piersonjones704/Scissor-Lift-Project/README.md

# Scissor Lift Project 
## Preventing scissor lift collisions on construction sites

### Overview  
This project, developed in collaboration with **Skanska**, aims to reduce jobsite accidents by integrating a **low-cost collision detection and avoidance system** into industrial scissor lifts.  

---

### Team  
- **Team Members:** Pierson Jones, Parker Jones, Jack Oakman, Aaryan Nanekar 
- **Project Lead:** Pierson Jones
- **Mechatronics Team Lead:** Parker Jones 
- **Client Partner:** Skanska USA

---

### License  
This project is currently **private and under client collaboration**. Portions may be shared publicly for academic or demonstration purposes only.

---

### Acknowledgements  
Special thanks to **Skanska, Duke University’s EGR101 & EGR102 Course, Dr. Glass, and Shane Trent** for mentorship, technical guidance, and access to testing and prototyping facilities.
