piersonjones704/Scissor-Lift-Project/Generation1/docs/images/morphChart.jpg

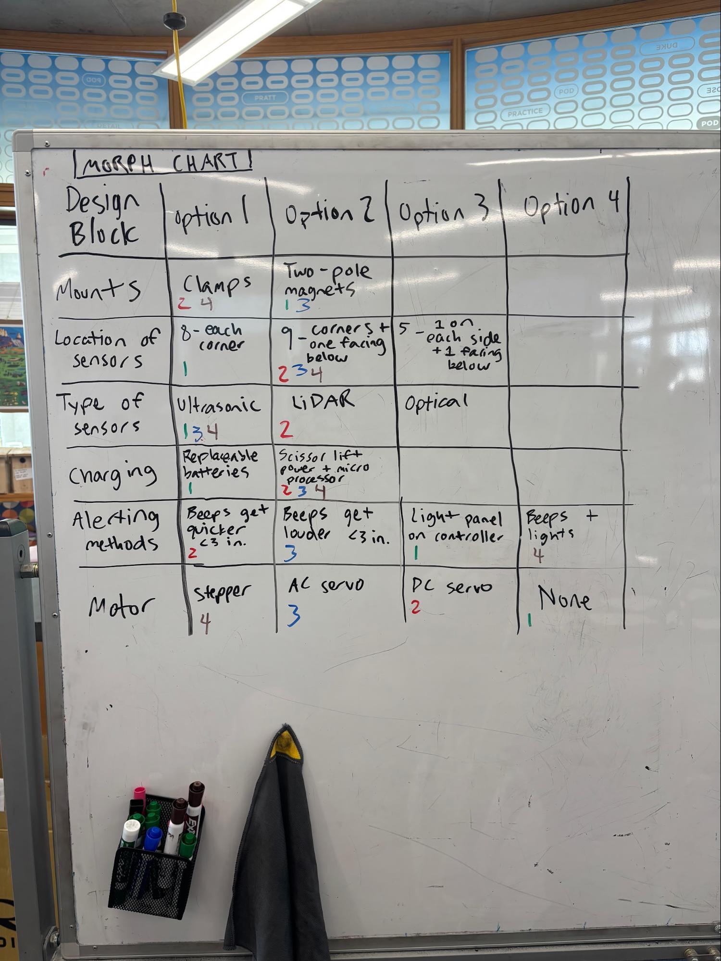
Generation1/docs/images/morphChart.jpg
