piersonjones704/Scissor-Lift-Project/Generation1/Planning Docs/IMG_5374.jpg

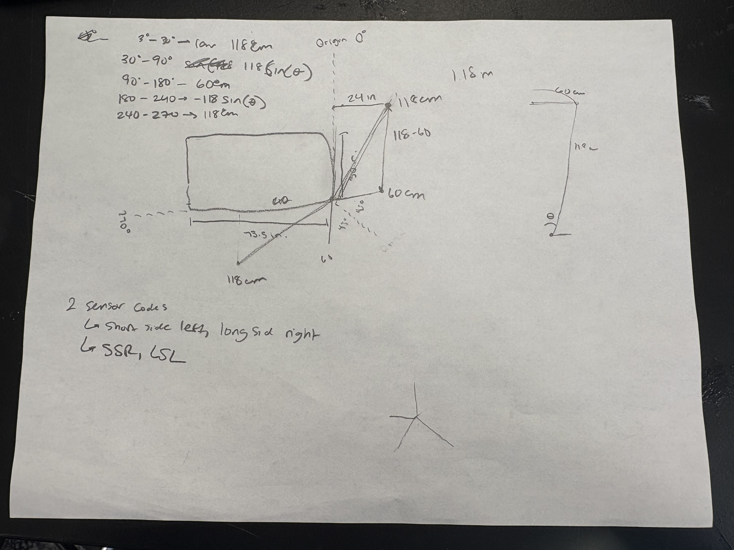
Generation1/Planning Docs/IMG_5374.jpg
