piersonjones704/Scissor-Lift-Project/Generation1/Planning Docs/Trig_SL_Sensing.jpg

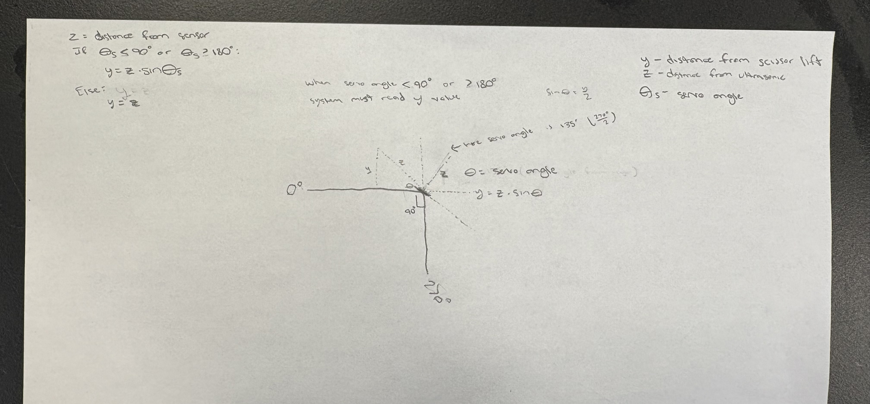
Generation1/Planning Docs/Trig_SL_Sensing.jpg
