piersonjones704/Scissor-Lift-Project/Generation2/InitialTofPrototyping/VL53L7CX Prototyping/VL53L7CX_System_Architecture.png

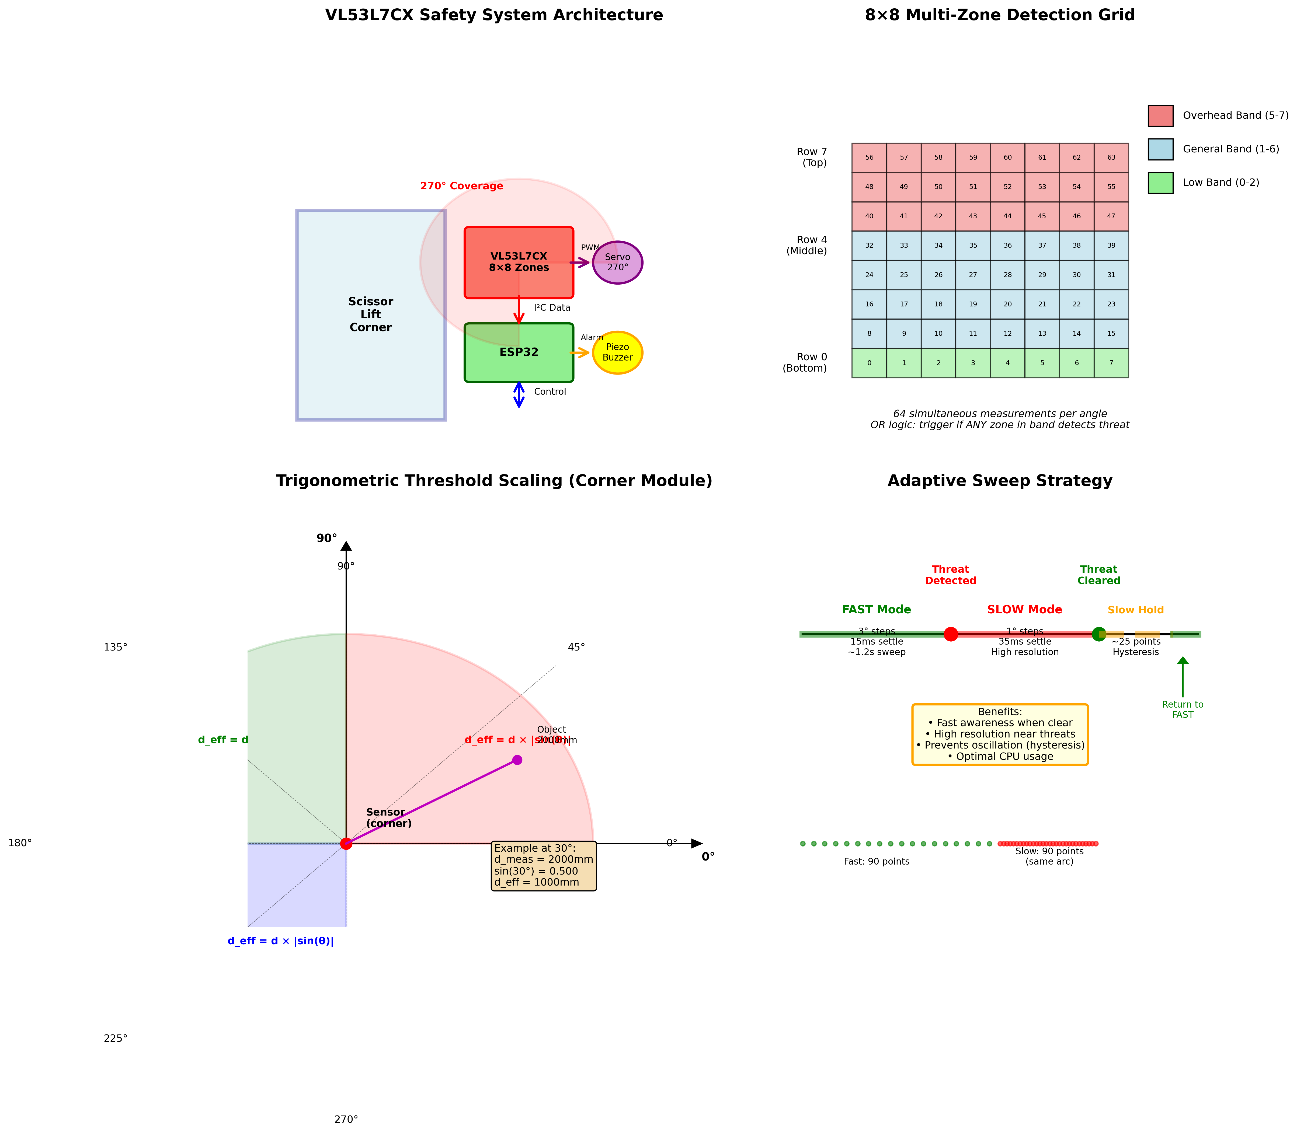
Generation2/InitialTofPrototyping/VL53L7CX Prototyping/VL53L7CX_System_Architecture.png
