piersonjones704/Scissor-Lift-Project/Generation2/TofBreakoutBoardDesign/DuPontVersion/Images/3DModelBottomView.png

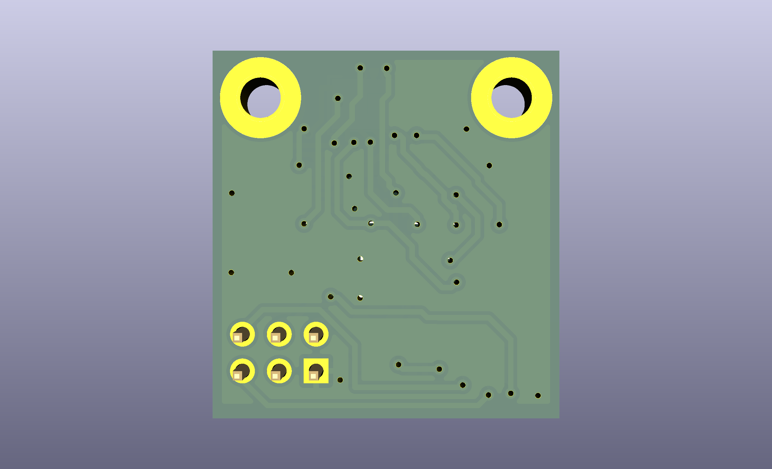
Generation2/TofBreakoutBoardDesign/DuPontVersion/Images/3DModelBottomView.png
