piersonjones704/Scissor-Lift-Project/Generation2/TofBreakoutBoardDesign/DuPontVersion/Images/3DModelFrontAngledView.png

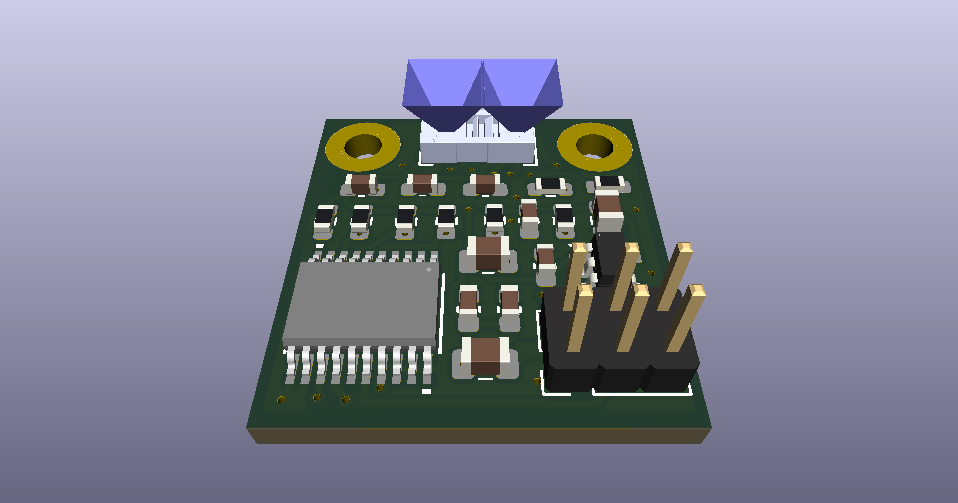
Generation2/TofBreakoutBoardDesign/DuPontVersion/Images/3DModelFrontAngledView.png
