piersonjones704/Scissor-Lift-Project/Generation2/TofBreakoutBoardDesign/DuPontVersion/Images/3DModelTopView.png

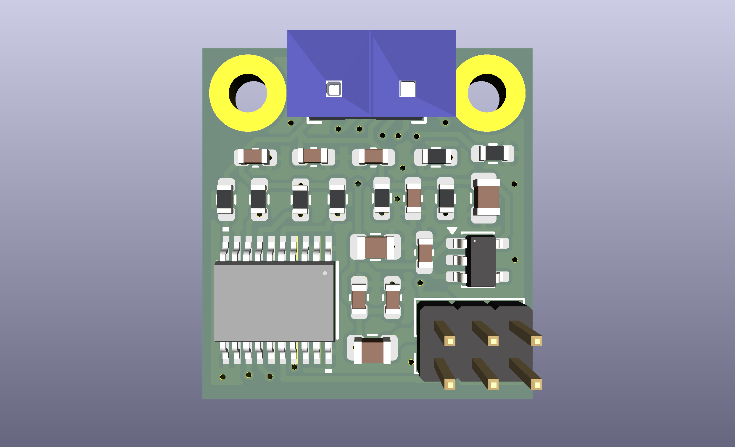
Generation2/TofBreakoutBoardDesign/DuPontVersion/Images/3DModelTopView.png
