piersonjones704/Scissor-Lift-Project/Generation2/TofBreakoutBoardDesign/DuPontVersion/Images/FrontAngledView.png

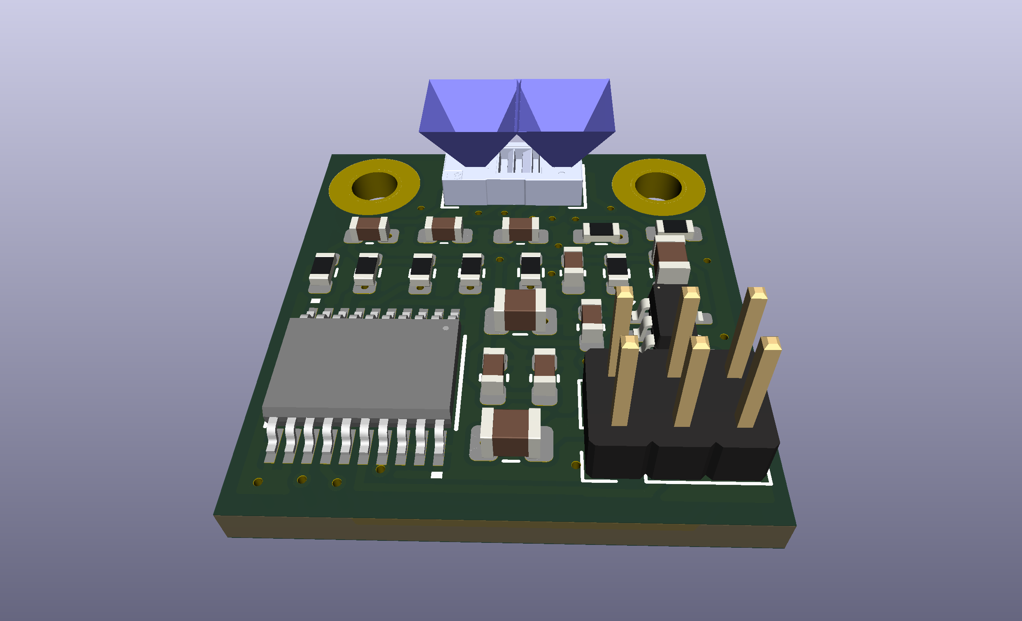
Generation2/TofBreakoutBoardDesign/DuPontVersion/Images/FrontAngledView.png
