piersonjones704/Scissor-Lift-Project/Generation2/TofBreakoutBoardDesign/DuPontVersion/Images/PCB_BackTracings.png

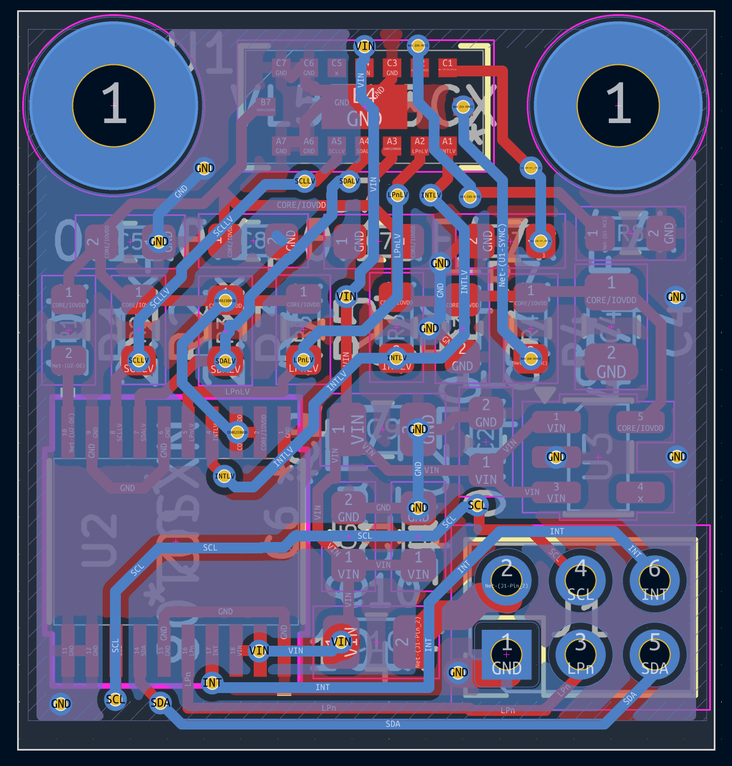
Generation2/TofBreakoutBoardDesign/DuPontVersion/Images/PCB_BackTracings.png
