piersonjones704/Scissor-Lift-Project/Generation2/TofBreakoutBoardDesign/DuPontVersion/Images/PCB_Front.png

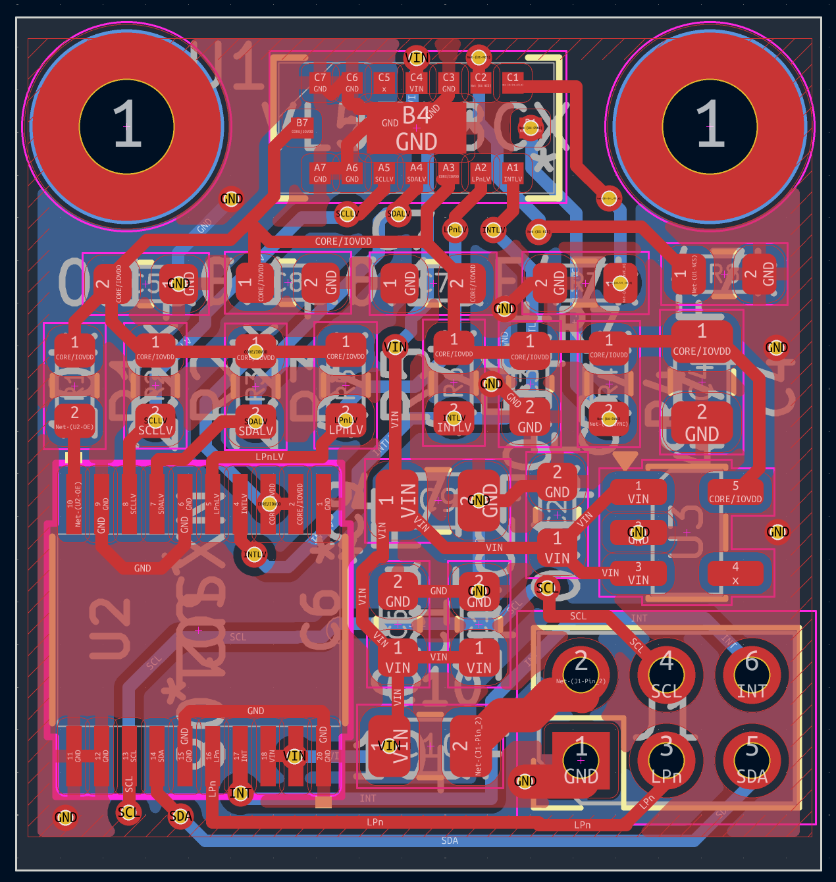
Generation2/TofBreakoutBoardDesign/DuPontVersion/Images/PCB_Front.png
