piersonjones704/Scissor-Lift-Project/Generation2/TofBreakoutBoardDesign/JST1x6RightAngleMountVersion/Images/3DModelBottomView.png

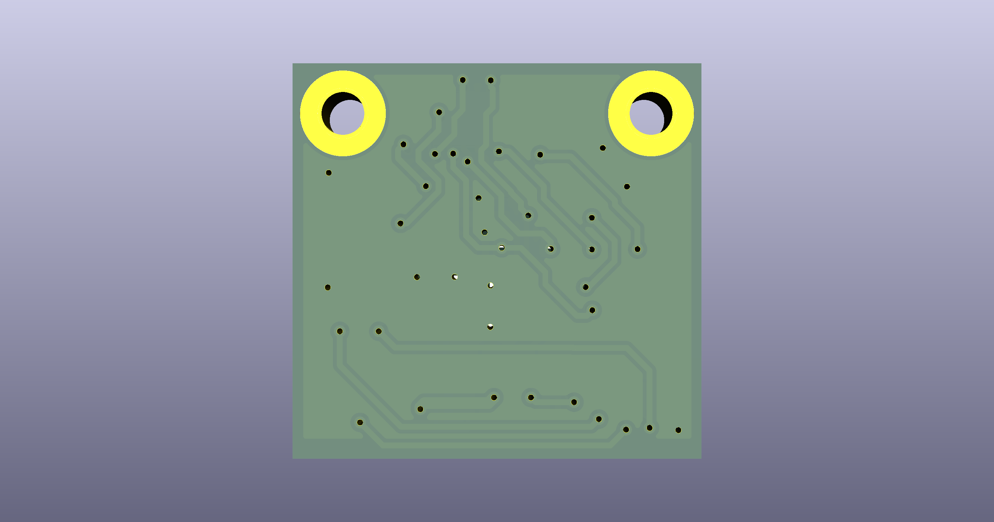
Generation2/TofBreakoutBoardDesign/JST1x6RightAngleMountVersion/Images/3DModelBottomView.png
