piersonjones704/Scissor-Lift-Project/Generation2/TofBreakoutBoardDesign/JST1x6RightAngleMountVersion/Images/3DModelTopView.png

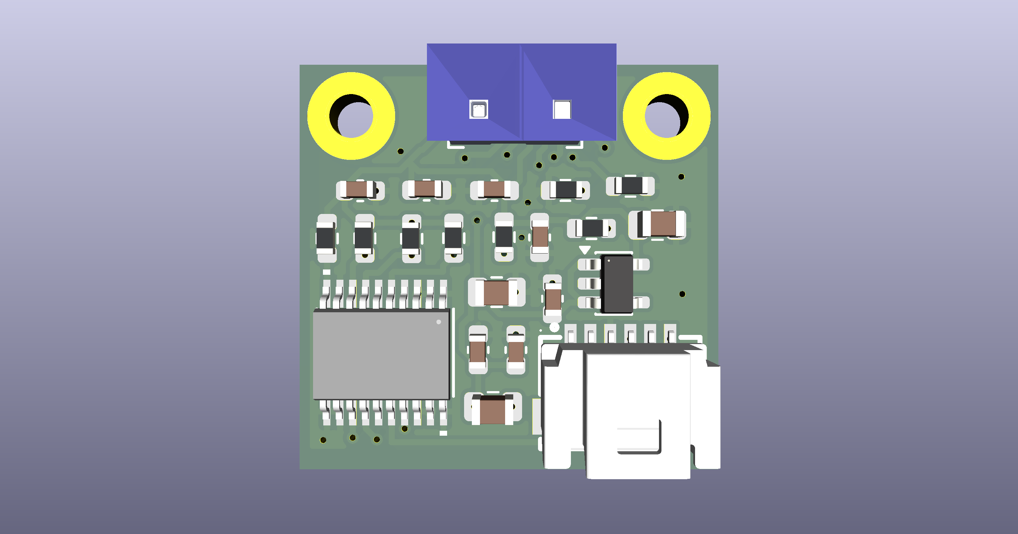
Generation2/TofBreakoutBoardDesign/JST1x6RightAngleMountVersion/Images/3DModelTopView.png
