piersonjones704/Scissor-Lift-Project/Generation2/TofBreakoutBoardDesign/JST1x6RightAngleMountVersion/Images/PCB_FrontTracings.png

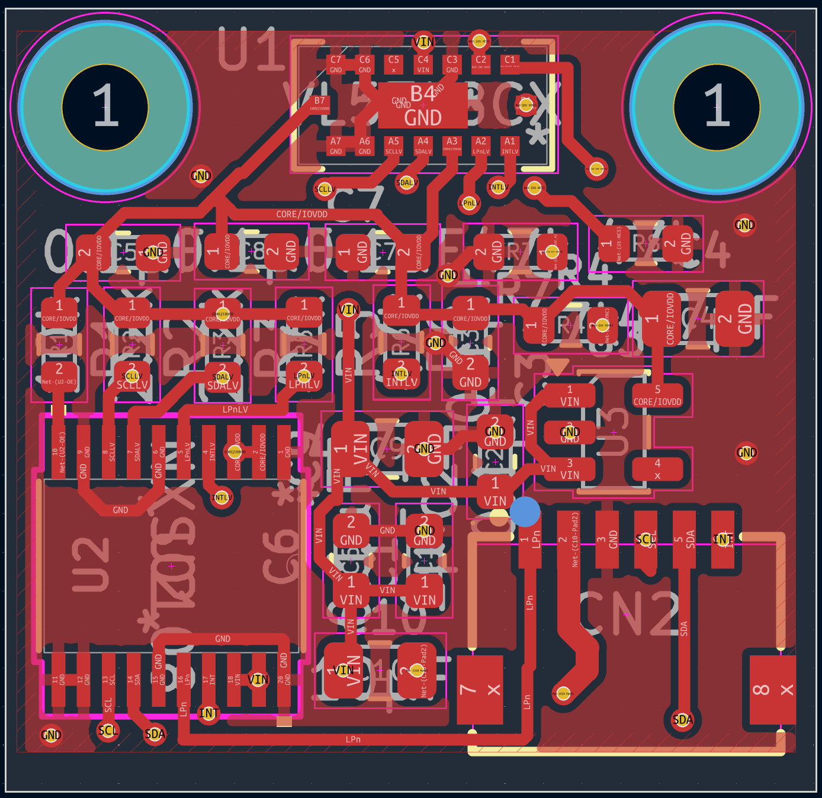
Generation2/TofBreakoutBoardDesign/JST1x6RightAngleMountVersion/Images/PCB_FrontTracings.png
