piersonjones704/Scissor-Lift-Project/Generation2/TofBreakoutBoardDesign/JST1x6VerticalMountVersion/Images/FrontAngledView.png

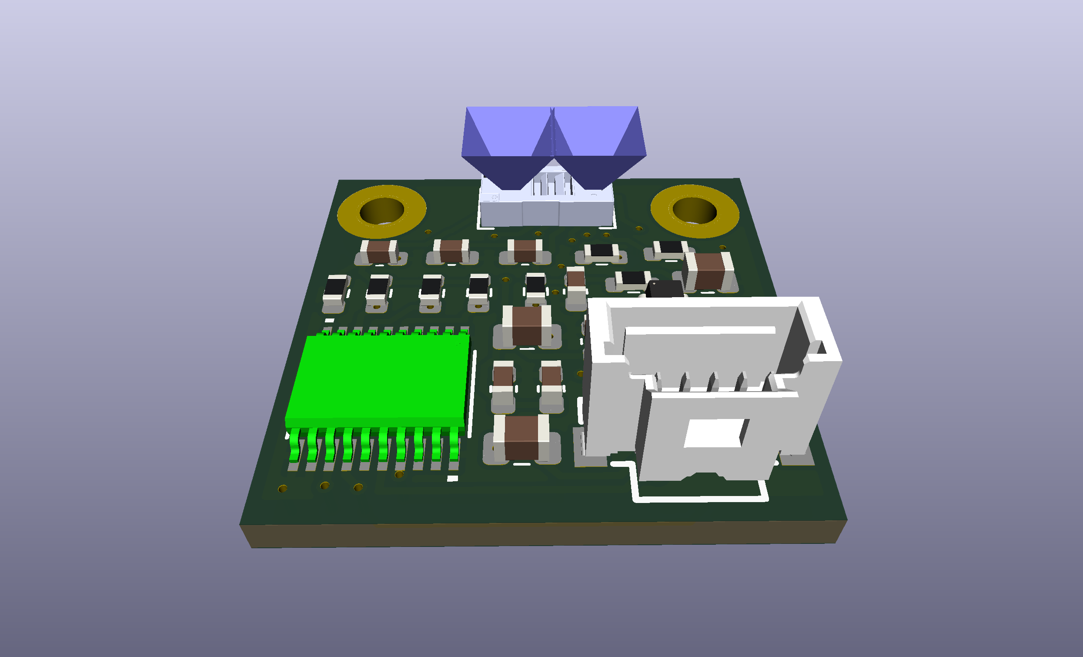
Generation2/TofBreakoutBoardDesign/JST1x6VerticalMountVersion/Images/FrontAngledView.png
