piersonjones704/Scissor-Lift-Project/Generation2/TofBreakoutBoardDesign/JST1x6VerticalMountVersion/Images/TopView.png

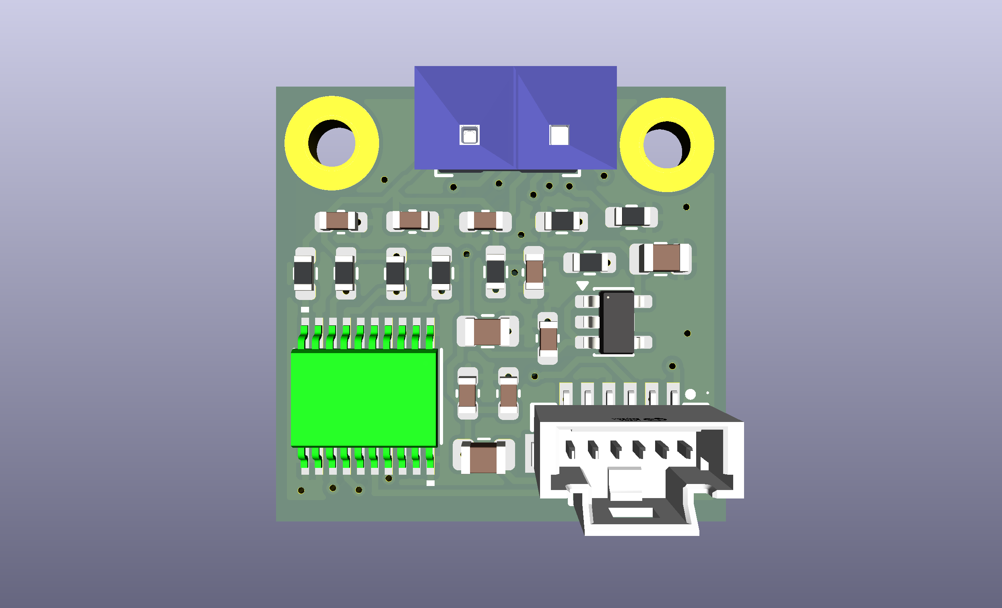
Generation2/TofBreakoutBoardDesign/JST1x6VerticalMountVersion/Images/TopView.png
