piersonjones704/Scissor-Lift-Project/Generation2/TofBreakoutBoardDesign/JSTVersion/Images/BottomView.png

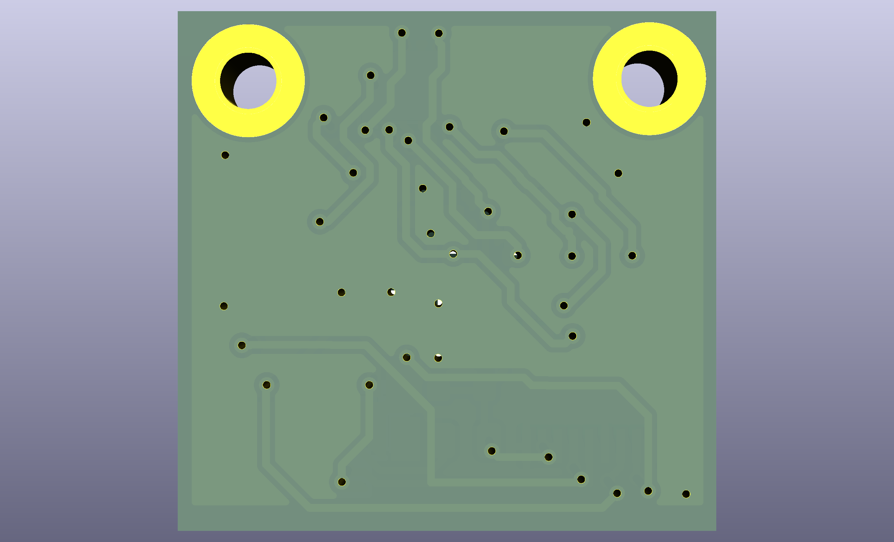
Generation2/TofBreakoutBoardDesign/JSTVersion/Images/BottomView.png
