piersonjones704/Scissor-Lift-Project/Generation2/TofBreakoutBoardDesign/JST1x6RightAngleMountVersion/ManufacturingFiles/VL53L8CXRightAngleMounted_BOM.csv

Reference | Value | Datasheet | Footprint | Qty | LCSC Part | Manufacturer
C1 | 1µF | https://jlc-prod-smt.oss-eu-central-1.aliyuncs.com/smtDataManualFile/8586178147351990272-C1592.pdf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 | Capacitor_SMD:C_0603_1608Metric | 1 | C1592 | Samsung Electro-Mechanics
C2,C3,C5,C6,C7,C8 | 0.1µF | https://jlc-prod-smt.oss-eu-central-1.aliyuncs.com/smtDataManualFile/8586177280415059968-C1591.pdf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 | Capacitor_SMD:C_0603_1608Metric | 6 | C1591 | Samsung Electro-Mechanics
C4,C9 | 4.7µF | https://jlc-prod-smt.oss-eu-central-1.aliyuncs.com/smtDataManualFile/8586178171934400512-C1746.pdf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 | Capacitor_SMD:C_0805_2012Metric | 2 | C1746 | Samsung Electro-Mechanics
C10 | 10µF | https://jlc-prod-smt.oss-eu-central-1.aliyuncs.com/smtDataManualFile/8579706853607202816-C15850.pdf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 | Capacitor_SMD:C_0805_2012Metric | 1 | C15850 | Samsung Electro-Mechanics
CN2 | Right Angle Locking Connector | https://www.lcsc.com/datasheet/C505000.pdf | JLCPCB_Library:CONN-SMD_6P-P1.00_5015680607 | 1 | C505000 | MOLEX
R1 | 10k | https://jlc-prod-smt.oss-eu-central-1.aliyuncs.com/smtDataManualFile/8588882000246165504-C15401.pdf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 | Resistor_SMD:R_0603_1608Metric | 1 | C15401 | UNI-ROYAL(Uniroyal Elec)
R2,R3 | 2.2k | https://jlc-prod-smt.oss-eu-central-1.aliyuncs.com/smtDataManualFile/8579706158411464704-C4190.pdf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 | Resistor_SMD:R_0603_1608Metric | 2 | C4190 | UNI-ROYAL(Uniroyal Elec)
R4,R5,R6,R7,R8 | 47k | https://jlc-prod-smt.oss-eu-central-1.aliyuncs.com/smtDataManualFile/8588882090821214208-C25600.pdf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 | Resistor_SMD:R_0603_1608Metric | 5 | C25600 | UNI-ROYAL(Uniroyal Elec)
U1 | VL53L8CX | https://www.st.com/resource/en/datasheet/vl53l8cx.pdf | VL53L8CX:VL53L8CX | 1 | C7386355 | STMicroelectronics
U2 | NXS0108 | https://jlc-prod-smt.oss-eu-central-1.aliyuncs.com/smtDataManualFile/8590908255990329344-C4364113.pdf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 | NXS0108:NXS0108 | 1 | C4364113 | Nexperia
U3 | AP2112K-1.8 | https://www.diodes.com/assets/Datasheets/AP2112.pdf | Package_TO_SOT_SMD:SOT-23-5 | 1 | C176944 | Diodes Incorporated
