piersonjones704/Scissor-Lift-Project/Generation2/TofBreakoutBoardDesign/JST1x6RightAngleMountVersion/VL53L8CXBreakoutBoardJSTRightAngleVersion.kicad_pcb

## KiCad design Generation2/TofBreakoutBoardDesign/JST1x6RightAngleMountVersion/VL53L8CXBreakoutBoardJSTRightAngleVersion.kicad_pcb (2026-11-14)

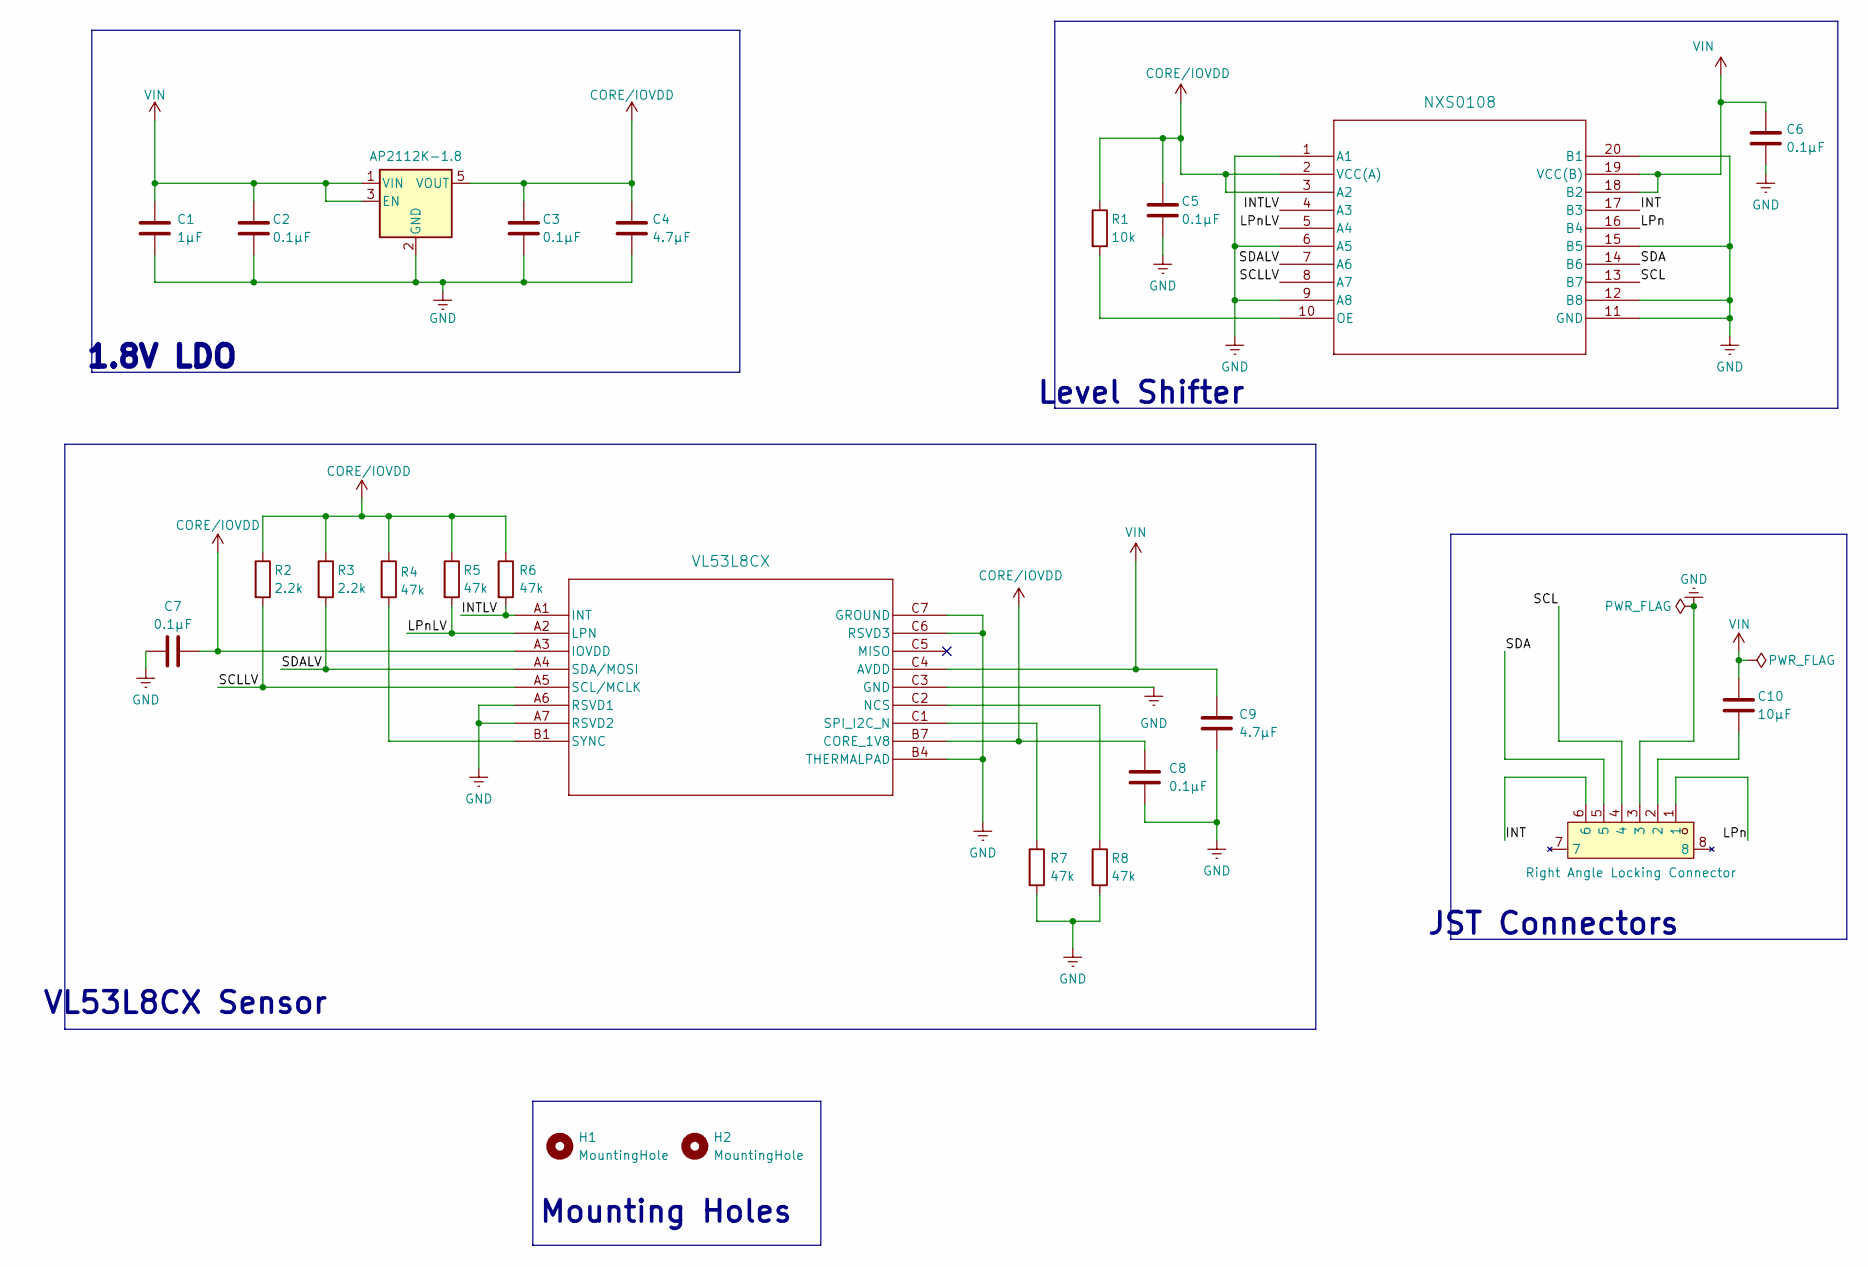
[picture p25: schematic VL53L8CXBreakoutBoardJSTRightAngleVersion.kicad_sch, VL53L8CX Sensor Breakout Board]

Parts:
C1: 1µF; C_0603_1608Metric; LCSC Part C1592
C2, C3, C5, C6, C7, C8: 0.1µF; C_0603_1608Metric; LCSC Part C1591
C4, C9: 4.7µF; C_0805_2012Metric; LCSC Part C1746
C10: 10µF; C_0805_2012Metric; LCSC Part C15850
CN2: Right Angle Locking Connector; CONN-SMD_6P-P1.00_5015680607; MPN 5015680607; LCSC Part C505000
H1, H2: MountingHole; MountingHole_2.2mm_M2
R1: 10k; R_0603_1608Metric; LCSC Part C15401
R2, R3: 2.2k; R_0603_1608Metric; LCSC Part C4190
R4, R5, R6, R7, R8: 47k; R_0603_1608Metric; LCSC Part C25600
U1: VL53L8CX; LCSC Part C7386355
U2: NXS0108; LCSC Part C4364113
U3: AP2112K-1.8; SOT-23-5; LCSC Part C176944

Connections:
/INT: CN2.6, U2.17 (B3)
/INTLV: R6.2, U1.A1 (INT), U2.4 (A3)
/LPn: CN2.1, U2.16 (B4)
/LPnLV: R5.2, U1.A2 (LPN), U2.5 (A4)
/SCL: CN2.4, U2.13 (B7)
/SCLLV: R2.2, U1.A5 (SCL/MCLK), U2.8 (A7)
/SDA: CN2.5, U2.14 (B6)
/SDALV: R3.2, U1.A4 (SDA/MOSI), U2.7 (A6)
CORE/IOVDD: C3.1, C4.1, C5.2, C7.2, C8.1, R1.1, R2.1, R3.1, R4.1, R5.1, R6.1, U1.A3 (IOVDD), U1.B7 (CORE_1V8), U2.2 (VCC(A)), U2.3 (A2), U3.5 (VOUT)
GND: C1.2, C2.2, C3.2, C4.2, C5.1, C6.2, C7.1, C8.2, C9.2, CN2.3, R7.2, R8.2, U1.A6 (RSVD1), U1.A7 (RSVD2), U1.B4 (THERMALPAD), U1.C3 (GND), U1.C6 (RSVD3), U1.C7 (GROUND), U2.1 (A1), U2.6 (A5), U2.9 (A8), U2.11 (GND), U2.12 (B8), U2.15 (B5), U2.20 (B1), U3.2 (GND)
unnamed: C10.2, CN2.2
unnamed: R8.1, U1.C2 (NCS)
unnamed: R7.1, U1.C1 (SPI_I2C_N)
unnamed: R4.2, U1.B1 (SYNC)
unnamed: R1.2, U2.10 (OE)
VIN: C1.1, C2.1, C6.1, C9.1, C10.1, U1.C4 (AVDD), U2.18 (B2), U2.19 (VCC(B)), U3.1 (VIN), U3.3 (EN)

Notes on the sheet:
Mounting Holes
Level Shifter
JST Connectors
VL53L8CX Sensor
1.8V LDO

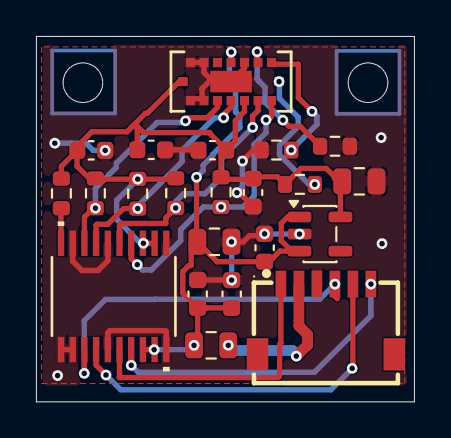
[picture p26: board VL53L8CXBreakoutBoardJSTRightAngleVersion.kicad_pcb from above]

Board: 2 copper layers, 21.0 x 20.3 mm, 24 parts (0 on the bottom side), 16 nets.
