piersonjones704/Scissor-Lift-Project/Generation2/Power_Optimization_Testing/Code Files/I2C_Scanner_Sketch/I2C_Scanner_Sketch.ino

#include <Wire.h>
#define SDA_PIN 8
#define SCL_PIN 9

void setup() {
  Serial.begin(115200);
  delay(2000);
  Wire.setPins(SDA_PIN, SCL_PIN);
  Wire.begin();
  Wire.setClock(100000);
}

void loop() {
  Serial.println("Scanning...");
  for (byte addr = 1; addr < 127; addr++) {
    Wire.beginTransmission(addr);
    if (Wire.endTransmission() == 0) {
      Serial.print("  0x");
      if (addr < 16) Serial.print("0");
      Serial.println(addr, HEX);
    }
  }
  delay(500);
}
