piersonjones704/Scissor-Lift-Project/(commit log)

2026-07-09 Ultrasonic sensors prototyping code and testing pictures/videos
2026-07-09 Adding all the files and work I completed Spring Semester 2026
2026-07-17 Found and imported the final code createed for the prototype that integrated trigonometry.
2026-07-17 edited readme to reflect actual servo we utilized
2026-07-17 Re-organized power testing folder. Added the results document along with the optimized configuration.
2026-07-17 Fixed Readme to reflect correct servo sweeping logistics.
2026-09-08 After prototyping with mux, achieved reliable connection with 2 VL53L8CX sensors simultaneously. Adjusted Gen2 readme to reflect this prototyping.
2026-09-08 Adjusted team member roles to reflect current status.
2026-09-08 Changed the Wire.setClock() back up to 100000. 10k Hz can mask/create edge-case timing bugs that won't show up at spec speed thus 100k Hz was necessary.
    [MUX_TestCode.ino]
2026-09-10 After more prototyping with the mux it has been determined that channel 4 is unreliable and thus, sensor 5 will be assigned to channel 5 now.
2026-09-10 Changed for loop on line 52 to loop to channel 6 instead of channel 5. This is because we had to move sensors 5 & 6 from channels 4 & 5 to channels 5 & 6. (result of unreliable channel 4)
2026-09-15 Updated README to reflect the completion of 6 sensor multiplexing. Added and adjusted the next steps portion to reflect our future plans for this generation.
2026-09-15 Fixed title of sketch in comments to reflect the actual title. The previous title was from what it used to be titled.
    [1TOFSensorModule_PerformanceCode.ino]
2026-09-15 Fixed titling to reflect that this sketch is different from the ESP32 sleep sketch which is the sketch titled as test6 - associated with TestID 13.
    [Supplementary_SensorSoftwareSleepCharacterization.ino]
2026-09-15 Removed from repo, not relevant with MUX currently working.
2026-09-15 Added the unique testing IDs that each test sketch corresponds with for improved clarity and understanding when comparing code to the power optimization results testing doc
2026-09-21 Performed more sensor zone calibration. Added sections that provide an overview of the results in determining what portions of the 4x4 grid represent different spatial zones (top left, bottom left, m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
2026-09-21 This code sketch displays in the serial monitor, the distance data for each sensor (Top-left, top-middle, etc.). So instead of there being distance data for the module as a whole, we can differentiat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
2026-09-24 Added zone slection hysteresis for improved stability between x, y, and z readings from each sensor. If a stationary object is near the boundary of two zones then there may be flickering between read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
    [MultiSensorAngleCalibration.ino]
2026-10-06 Made some slight changes to the power optimization testing doc. I re-ran test 13 to clear up some confusion regarding how USB affects measured current draw of the system. This time I ran it just usin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
2026-10-21 Documentation utilized for the VL53L8CX Sensor. Made an external resources folder to hold documentation and similar resources.
2026-10-22 Add VL53L8CX breakout board schematic, PCB footprint progress, and custom libraries
2026-10-22 Changed I2C Frequency to fast mode (400 kHz)
2026-10-22 Created a libraries folder to hold the custom footprints and symbols
2026-10-22 Reorganize KiCad libraries and update footprint assignments
2026-10-22 Created an Images folder to display the major milestones of how the schematic and pcb footprint designs look. With this commit the schematic is in its completed state. If a change is made the image w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
2026-11-06 Made some modifications to the schematic and changed the type of mounting holes utilized.
2026-11-10 Completed first iteration of PCB in PCB editor. Need to do one final revision and confirmation that pcb is ready to be manufactured.
2026-11-12 Seperated two versions of the PCB - a version that utilizes a JST Connector and one that utilizes DuPont ends. I added seperate folders for each and images that correspond with each board (a schemati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
2026-11-12 Added images of the front and back copper layers in PCB Editor View of both the DuPont and JST PCB versions.
2026-11-12 Found a right angle mounted 1x6 Locking JST Connector on JCLPCB's components list. Using a right angle mounted connector will ensure no wires disrupt the view of the sensor.
2026-11-12 Added rule to ignore backups from kicad during commits.
2026-11-12 Slightly shifted the mounting holes to be in alignment. Updated images to reflect these changes.
2026-11-12 Changed the mounting holes to not have copper pads.
2026-11-12 Adjusted keep out zones around mounting holes.
2026-11-14 Created Gerber, Drill, BOM and Component Placement files for manufacturing.
